jwcxz/bt/sw/bc-algo/README.md

Beat Classifier Development
===========================

These scripts provide a framework for fine-tuning beat classifiers
