jwcxz/bt/doc/05-implementation-status/fig/swscreenshot.png

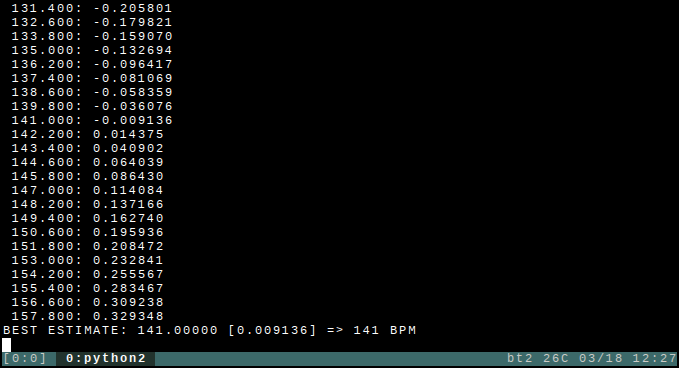
doc/05-implementation-status/fig/swscreenshot.png
