jwcxz/bt/doc/07-first-run/fig/swscreenshot.png

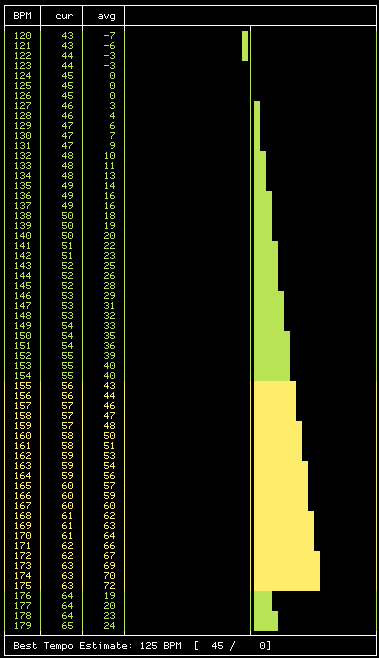
doc/07-first-run/fig/swscreenshot.png
