jwcxz/bt/doc/09-final-report/fig/architecture.pdf

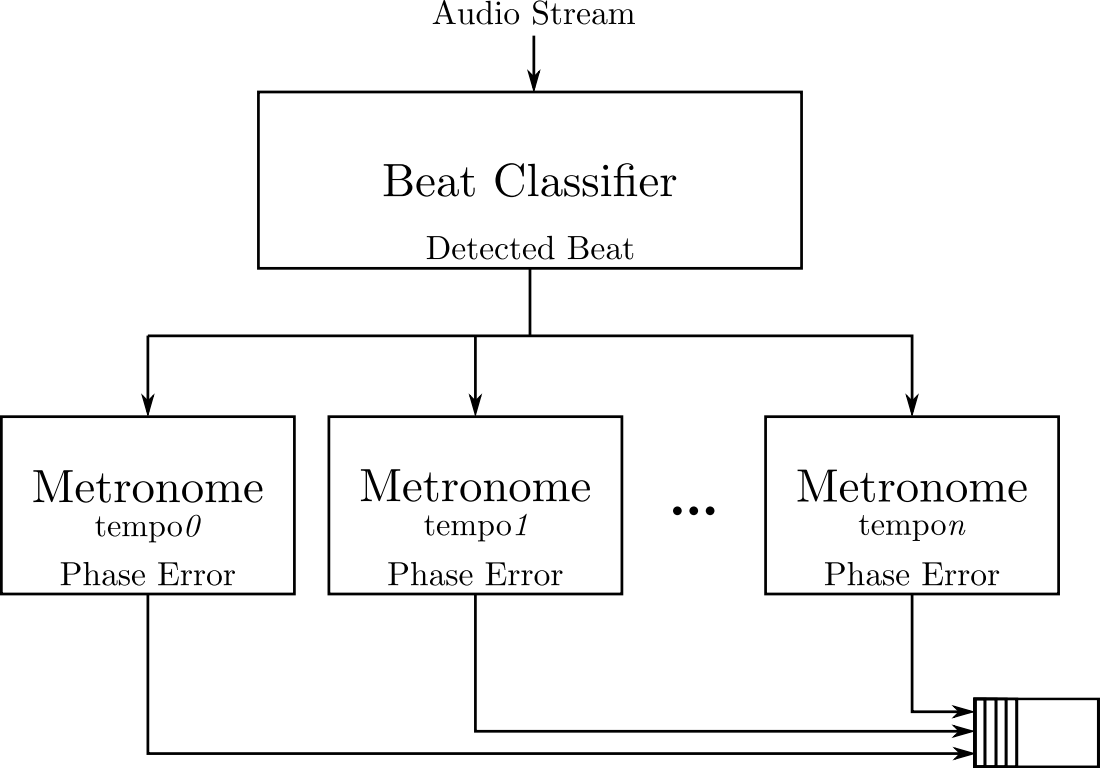
[picture p6: page 1]
