jwcxz/bt/doc/09-final-report/fig/dcbias.pdf

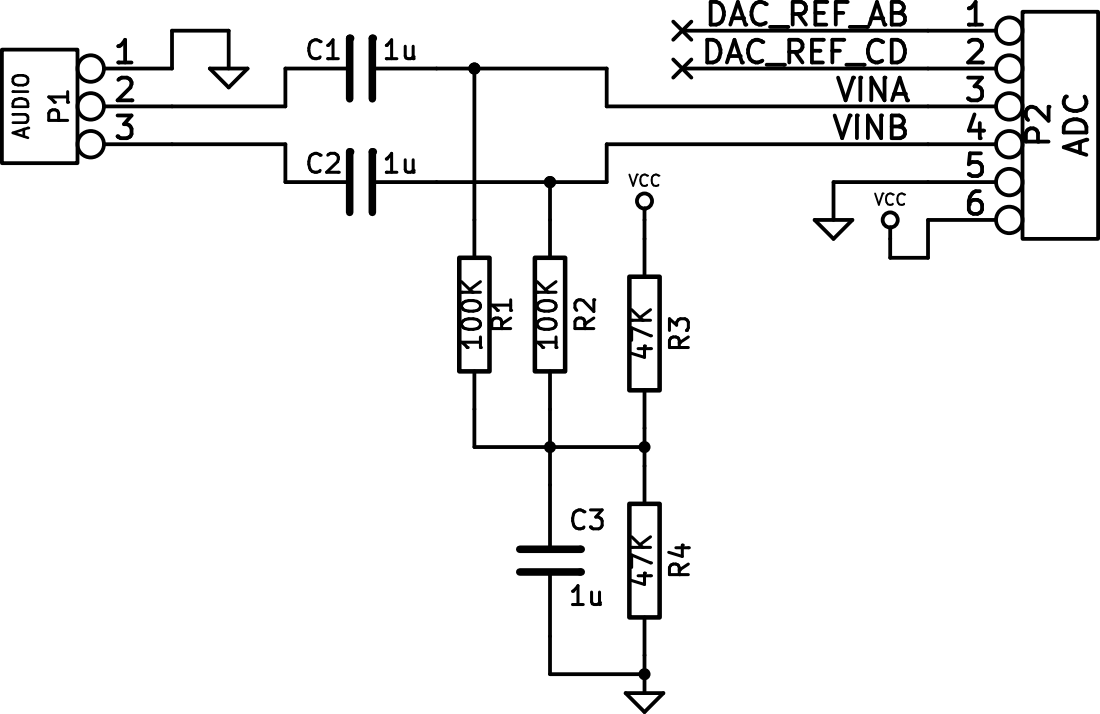
[picture p7: page 1]
