jwcxz/bt/doc/09-final-report/fig/hwarch.pdf

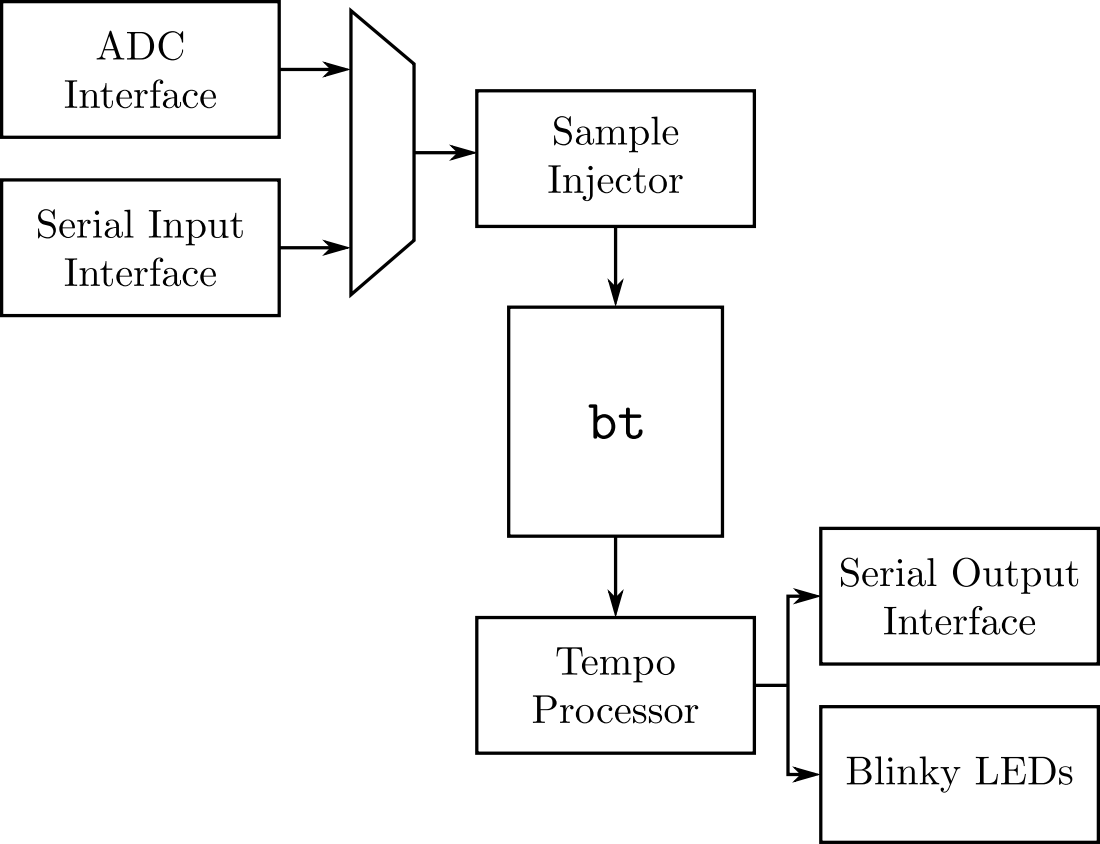
[picture p8: page 1]
