jwcxz/bt/pcb/audioin/audioin-Back.pdf

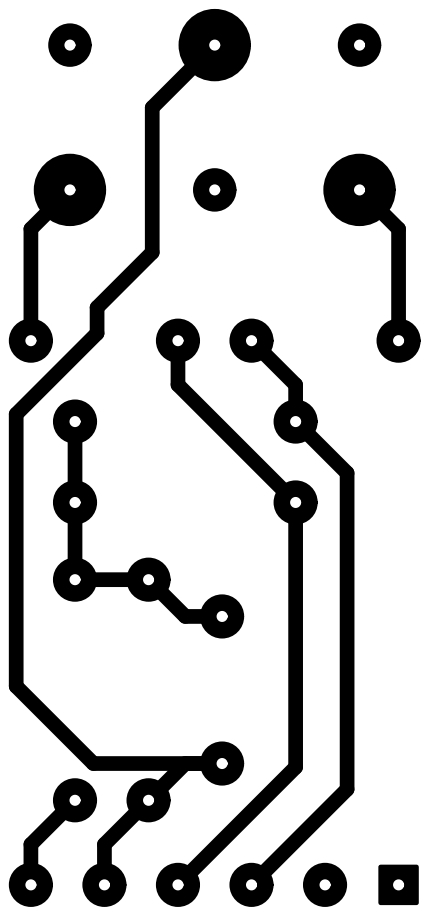
[picture p9: page 1]
