jwcxz/bt/doc/10-final-presentation/fig/hwarch.pdf

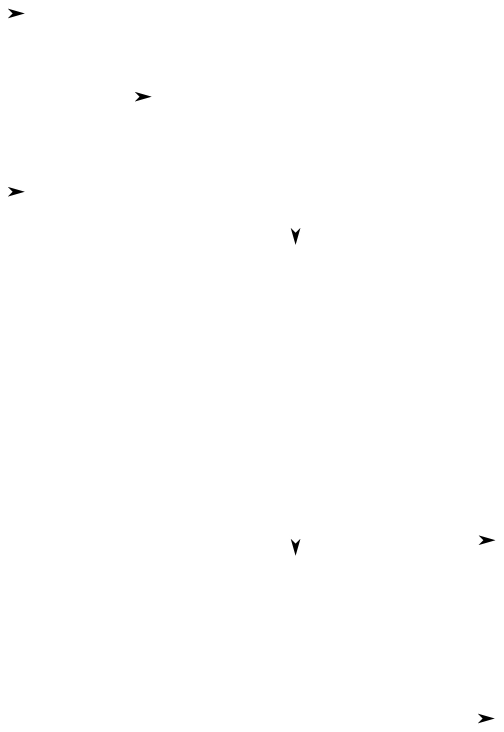
[picture p10: page 1]
