jwcxz/bt/doc/10-final-presentation/fig/target.pdf

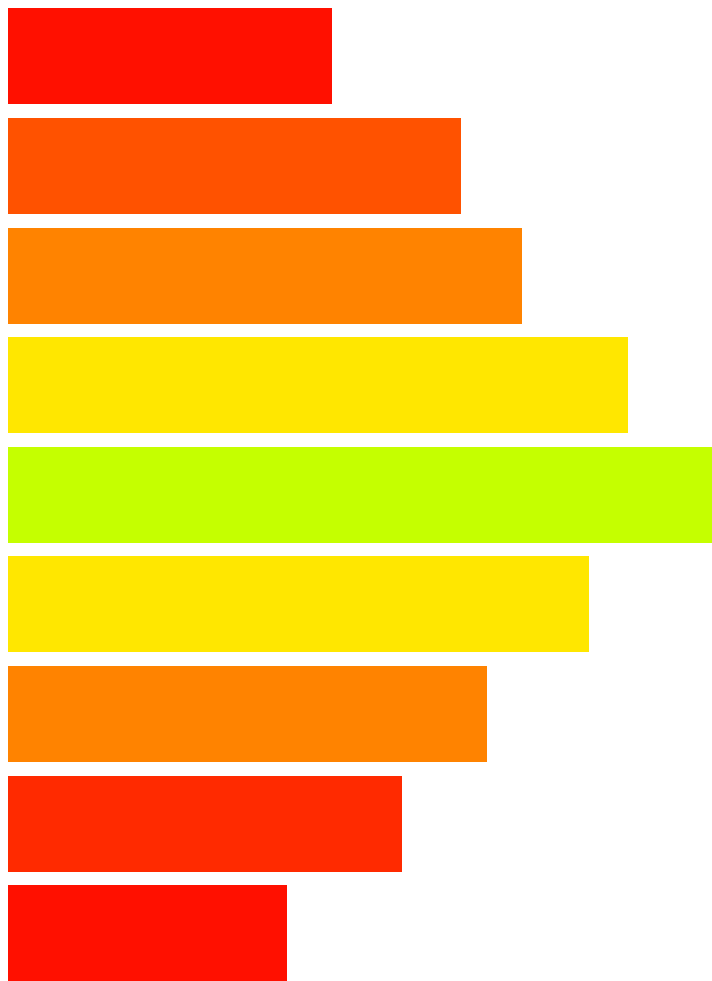
[picture p11: page 1]
