jwcxz/bt/doc/05-implementation-status/fig/architecture.pdf

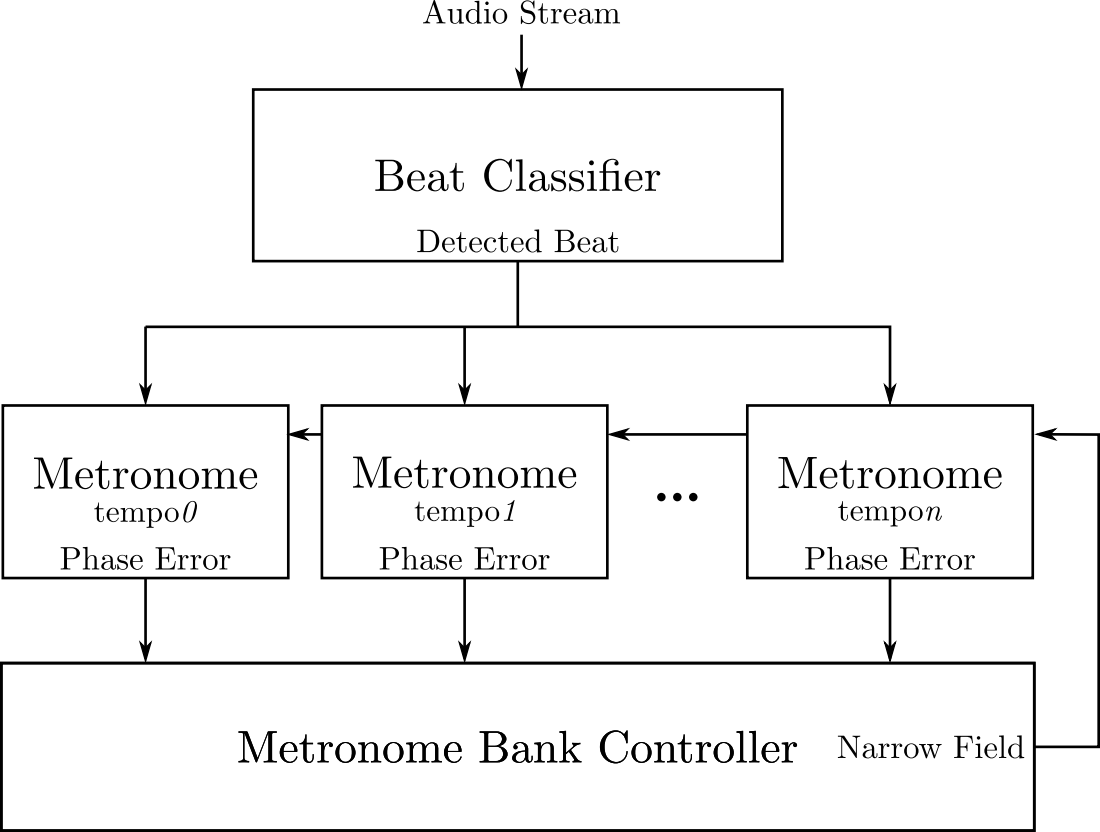
[picture p12: page 1]
