jwcxz/bt/pcb/audioin/audioin.sch

## KiCad design pcb/audioin/audioin.sch (2013-04-01)

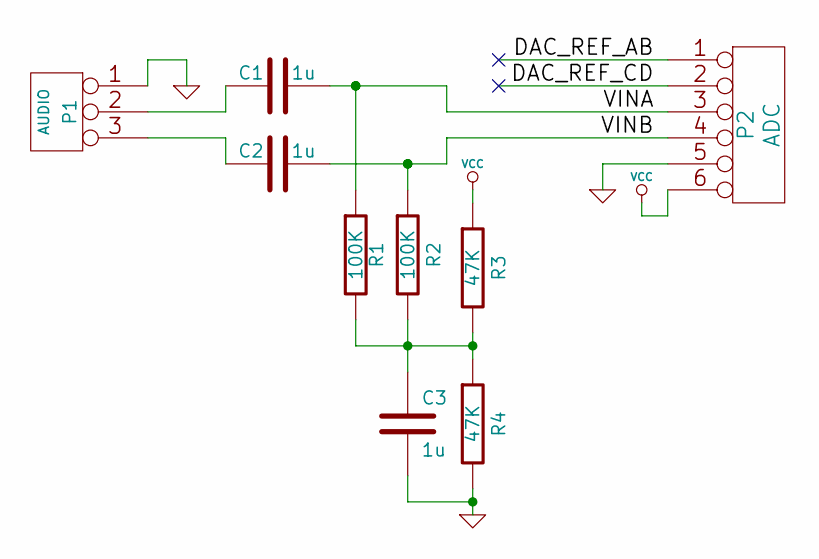
[picture p13: schematic audioin.sch]

Parts:
C1, C2, C3: 1u
P1: AUDIO
P2: ADC
R1, R2: 100K
R3, R4: 47K

Connections:
DAC_REF_AB: P2.1
DAC_REF_CD: P2.2
GND: C3.2, P1.1, P2.5, R4.2
unnamed: C1.1, P1.2 (PM)
unnamed: C2.1, P1.3
unnamed: C3.1, R1.2, R2.2, R3.2, R4.1
VCC: P2.6, R3.1
VINA: C1.2, P2.3, R1.1
VINB: C2.2, P2.4, R2.1
