jwcxz/bt/fpga/hdl/top.vhd

-- bt - hardware beat tracker
-- top level module

library ieee;
use ieee.std_logic_1164.all;
use ieee.numeric_std.all;

library work;
use work.all;
use work.dsize_pkg.all;

entity project is
    port (
        clk_50m : in  std_logic;
        
        led : out std_logic_vector(7 downto 0);

        sw        : in  std_logic_vector(3 downto 0);
        btn_east  : in  std_logic;
        btn_north : in  std_logic;
        btn_south : in  std_logic;
        btn_west  : in  std_logic;

        rs232_dce_rxd : in  std_logic;
        rs232_dce_txd : out std_logic;

        spi_sck  : out std_logic;
        spi_mosi : out std_logic;
        spi_miso : in  std_logic;
        amp_out  : in  std_logic;
        dac_out  : in  std_logic;
        adc_out  : in  std_logic;
        
        spi_ss_b : out std_logic;
        alt_ss_b : out std_logic;
        amp_cs   : out std_logic;
        dac_cs   : out std_logic;
        ad_conv  : out std_logic;

        amp_shdn      : out std_logic;
        dac_clr       : out std_logic;
        st_spi_wp     : out std_logic;
        dataflash_wp  : out std_logic;
        dataflash_rst : out std_logic;

        fpga_init_b : out std_logic
    );
end project;

architecture project_arch of project is

    constant BT_INFO_SZ : integer := 8;

    component mkBeatTracker is
        port (
            CLK : in std_logic;
            RST_N : in std_logic;

            EN_q_sync  : in  std_logic;
            RDY_q_sync : out std_logic;

            putSampleInput_in  : in std_logic_vector(2*SAMPLE_WIDTH-1 downto 0);
            EN_putSampleInput  : in std_logic;
            RDY_putSampleInput : out std_logic;

            EN_getBeatInfo  : in std_logic;
            getBeatInfo     : out std_logic_vector(BT_INFO_SZ-1 downto 0);
            RDY_getBeatInfo : out std_logic
        );
    end component mkBeatTracker;

    signal clk25, clk50    : std_logic;
    signal rst, clk_locked, clk_rst, rst_n : std_logic;
    signal rst_dcount : unsigned(5 downto 0);

    signal uart_din, uart_dout : std_logic_vector(7 downto 0);
    signal uart_wr, uart_rd, uart_rda, uart_tbe : std_logic;
    signal uart_out_sync : std_logic;

    signal amp_cfg, adc_start, amp_done, adc_done : std_logic;
    signal amp_gain     : std_logic_vector(7 downto 0);
    signal adc_a, adc_b : std_logic_vector(13 downto 0);

    signal bt_sync_en, bt_sync_rdy : std_logic;

    signal sample_rdy, sample_rd : std_logic;
    signal sample : std_logic_vector(2*SAMPLE_WIDTH-1 downto 0);

    signal cs_control : std_logic_vector(35 downto 0);
    signal cs_data : std_logic_vector(127 downto 0);
    signal cs_trig : std_logic_vector(7 downto 0);

    signal bt_sample_in : std_logic_vector(2*SAMPLE_WIDTH-1 downto 0);
    signal bt_sample_en, bt_sample_rdy : std_logic;

    signal bt_info : std_logic_vector(BT_INFO_SZ-1 downto 0);
    signal bt_info_en, bt_info_rdy : std_logic;

begin

    -- set up clocking and reset
    clocking_inst : entity clocking
        port map (
            clk_in  => clk_50m,
            rst     => '0',
            clk1x   => clk50,
            clk_div => clk25,
            lock    => clk_locked
        );

    -- hold clocking reset for a few clock cycles to let things settle
    rst_hold : process(clk25)
    begin
        if (rising_edge(clk25)) then
            if (clk_locked = '0') then
                clk_rst <= '1';
                rst_dcount <= (others => '0');
            else
                if (rst_dcount = to_unsigned(2**(rst_dcount'length) - 1,
                                    rst_dcount'length)) then
                    clk_rst <= '0';
                    rst_dcount <= (others => '0');
                else
                    rst_dcount <= rst_dcount + 1;
                end if;
            end if;
        end if;
    end process;

    rst <= btn_south or clk_rst;
    rst_n <= not rst;


    -- disable other devices on the spi line
    spi_ss_b <= '1';
    alt_ss_b <= '1';
    dac_cs   <= '1';

    st_spi_wp     <= '0';
    dataflash_wp  <= '0';
    dataflash_rst <= '0';
    dac_clr       <= '1';

    -- yay we're configured
    fpga_init_b <= '0';


    -- led control
    process (clk25)
    begin
        if (rising_edge(clk25)) then
            if (sample_rdy = '1') then
                if sample(sample'high) = '1' then
                    led <= not sample(sample'high-1 downto sample'high-8);
                else
                    led <= sample(sample'high-1 downto sample'high-8);
                end if;
            end if;
        end if;
    end process;


    -- uart receiver and transmitter
    uart_inst : entity Rs232RefComp
        generic map (
            --baudDivide => x"A3"
            baudDivide => x"06" -- 115200
        )
        port map (
            txd => rs232_dce_txd,
            rxd => rs232_dce_rxd,
            clk => clk25,
            rst => rst,
            
            dbin => uart_din,
            wr   => uart_wr,

            dbout => uart_dout,
            rd    => uart_rd,
            pe    => open,
            fe    => open,
            oe    => open,

            rda => uart_rda,
            tbe => uart_tbe
        );


    -- pre-amp and adc controller
    amp_shdn <= '0';
    amp_adc_inst : entity amp_adc
        port map (
            clk => clk25,
            rst => rst,

            amp_cfg  => amp_cfg,
            gain     => amp_gain,
            amp_done => amp_done,

            start_conv => adc_start,
            adc_done   => adc_done,
            adc_a      => adc_a,
            adc_b      => adc_b,

            amp_cs    => amp_cs,
            adc_start => ad_conv,
            spi_sck   => spi_sck,
            spi_mosi  => spi_mosi,
            spi_adc   => adc_out,
            spi_amp   => amp_out
        );


    -- sample injector
    sample_injector_inst : entity sample_injector
        port map (
            clk => clk25,
            rst => rst,

            amp_cfg   => amp_cfg,
            adc_start => adc_start,
            gain      => amp_gain,
            
            amp_done => amp_done,
            adc_done => adc_done,
            adc_a    => adc_a,
            adc_b    => adc_b,

            sample_rdy => sample_rdy,
            sample     => sample,
            sample_rd  => sample_rd
        );


    -- main processor
    beat_tracker_inst : mkBeatTracker
        port map (
            CLK => clk25,
            RST_N => rst_n,

            EN_q_sync  => bt_sync_en,
            RDY_q_sync => bt_sync_rdy,

            putSampleInput_in  => bt_sample_in,
            EN_putSampleInput  => bt_sample_en,
            RDY_putSampleInput => bt_sample_rdy,

            getBeatInfo     => bt_info,
            EN_getBeatInfo  => bt_info_en,
            RDY_getBeatInfo => bt_info_rdy
        );


    -- serial synchronization
    process (clk25)
    begin
        if (rising_edge(clk25)) then
            if (rst = '1') then
                uart_rd <= '0';
            else
                if (uart_rda = '1') then
                    uart_rd <= '1';
                else
                    uart_rd <= '0';
                end if;
            end if;
        end if;
    end process;


    bt_sync_en <= uart_rda;


    bt_sample_in <= sample;
    bt_sample_en <= sample_rdy and bt_sample_rdy;
    sample_rd <= sample_rdy and bt_sample_rdy;


    bt_info_en <= bt_info_rdy and uart_tbe;
    uart_wr  <= bt_info_rdy and uart_tbe;

    process (clk25)
    begin
        if (rising_edge(clk25)) then
            if (rst = '1') then
                uart_din <= (others => '0');
            else
                if (bt_info_rdy = '1' and uart_tbe = '1') then
                    uart_din <= bt_info;
                end if;
            end if;
        end if;
    end process;


--    chipscope_icon_inst : entity chipscope_icon
--        port map (
--            CONTROL0 => cs_control
--        );
--
--    chipscope_ila_inst : entity chipscope_ila
--        port map (
--            CONTROL => cs_control,
--            CLK => clk25,
--            DATA => cs_data,
--            TRIG0 => cs_trig
--        );
--
--    reg_ila : process(clk25)
--    begin
--        if (rising_edge(clk25)) then
--            if (rst='1') then
--                cs_trig <= (others => '0');
--                cs_data <= (others => '0');
--
--            else 
--                cs_trig <= (7 downto 3 => '0') & uart_rda & bt_info_rdy & sample_rdy;
--                cs_data <= (127 downto 53 => '0') &
--                           uart_tbe & -- 52
--                           uart_rda & -- 51
--                           uart_din & -- 50:43
--                           uart_wr & -- 42
--                           bt_info & -- 41:34
--                           bt_info_en & -- 33
--                           bt_info_rdy & -- 32
--                           bt_sample_in & -- 31:18
--                           bt_sample_en & -- 17
--                           bt_sample_rdy & -- 16
--                           sample & -- 15:2
--                           sample_rd & -- 1
--                           sample_rdy; -- 0
--            end if;
--        end if;
--    end process;

end architecture;
