jwcxz/bt/fpga/hdl/cs/chipscope_ila.vhd

-------------------------------------------------------------------------------
-- Copyright (c) 2013 Xilinx, Inc.
-- All Rights Reserved
-------------------------------------------------------------------------------
--   ____  ____
--  /   /\/   /
-- /___/  \  /    Vendor     : Xilinx
-- \   \   \/     Version    : 13.2
--  \   \         Application: XILINX CORE Generator
--  /   /         Filename   : chipscope_ila.vhd
-- /___/   /\     Timestamp  : Thu Apr 04 16:28:11 EDT 2013
-- \   \  /  \
--  \___\/\___\
--
-- Design Name: VHDL Synthesis Wrapper
-------------------------------------------------------------------------------
-- This wrapper is used to integrate with Project Navigator and PlanAhead

LIBRARY ieee;
USE ieee.std_logic_1164.ALL;
ENTITY chipscope_ila IS
  port (
    CONTROL: inout std_logic_vector(35 downto 0);
    CLK: in std_logic;
    DATA: in std_logic_vector(127 downto 0);
    TRIG0: in std_logic_vector(7 downto 0));
END chipscope_ila;

ARCHITECTURE chipscope_ila_a OF chipscope_ila IS
BEGIN

END chipscope_ila_a;
