jwcxz/bt/(commit log)

2013-03-10 update phase locker so that it doesn't suck so much
    [bt.py]
2013-03-13 switch to a more traditional phase overflow method
2013-03-13 make it relatively easy to switch b/w center finding methods
    TODO: turn this into something abstract
2013-03-18 add doc framework, start preliminary proposal
2013-03-18 add schematics for audio input dc-biaser
    [audioin.sch]
2013-03-19 audio sample injector
2013-04-01 finished dc biaser
    [audioin.brd, audioin.sch]
2013-04-05 add base fpga framework (sends adc samples out over serial)
2013-04-05 leds should use approximate absolute value
2013-04-05 use ~48000kHz sampling rate, and slow down UART transfer using tbe flag
2013-04-05 add clock reset hold to fix amp startup bug
    [top.vhd]
2013-04-22 bits flowing, squashing bugs
    [sample_injector.vhd, top.vhd]
2013-04-25 major updates - mostly working save for some output queue issues
    [amp_adc.vhd, data_sizes.vhd, top.vhd]
2013-05-15 generate audioin svg schematic
